vaibhavshirole/piano-reader/(commit log)

2025-01-19 Sketch to print mux map and notice signal leakage
    [drawmap.cpp]
2025-01-20 Discovery of which pull up resistor to use
2025-02-03 WebSocket server ESP32 firmware
