vaibhavshirole/piano-reader/images/IMG_0588.JPG

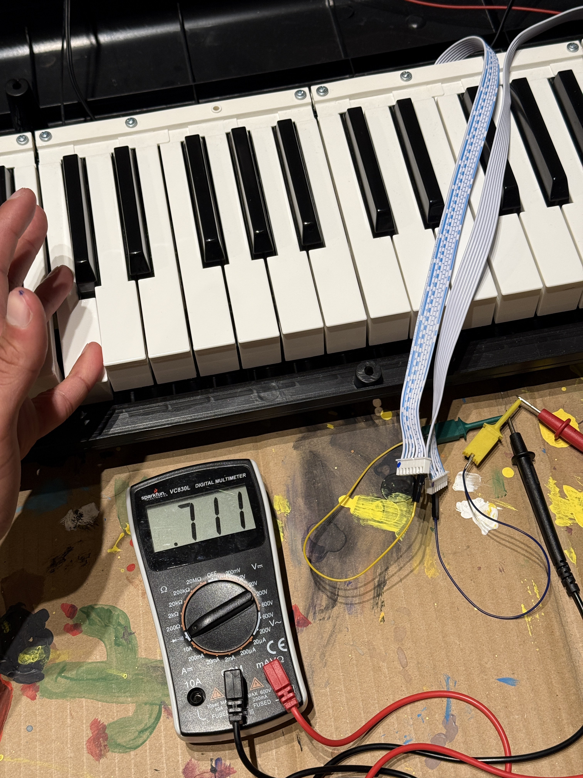
images/IMG_0588.JPG
