vaibhavshirole/piano-reader/images/IMG_0594.JPG

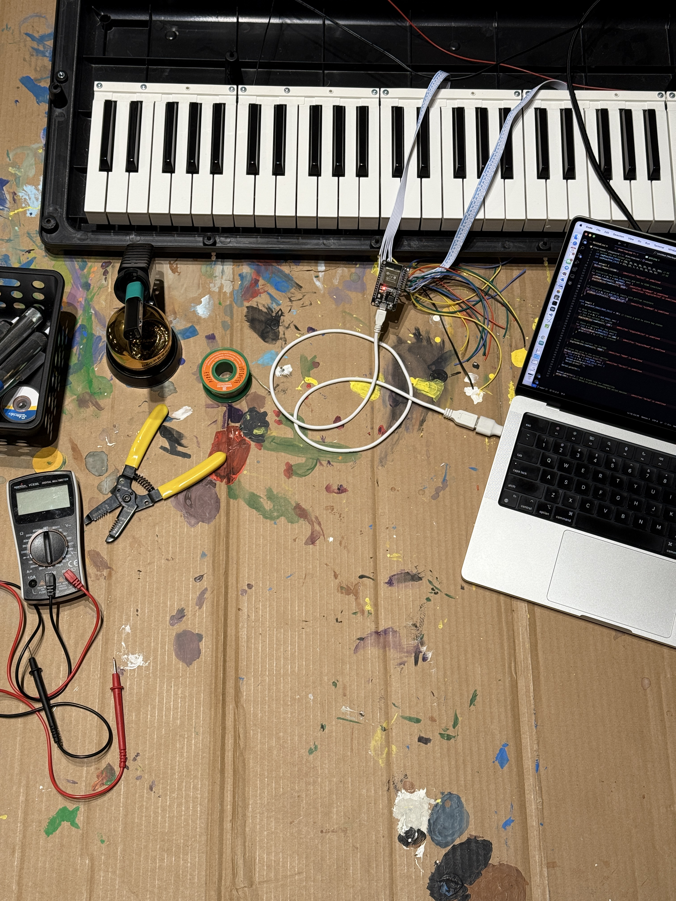
images/IMG_0594.JPG
