vaibhavshirole/piano-reader/images/IMG_0601.JPG

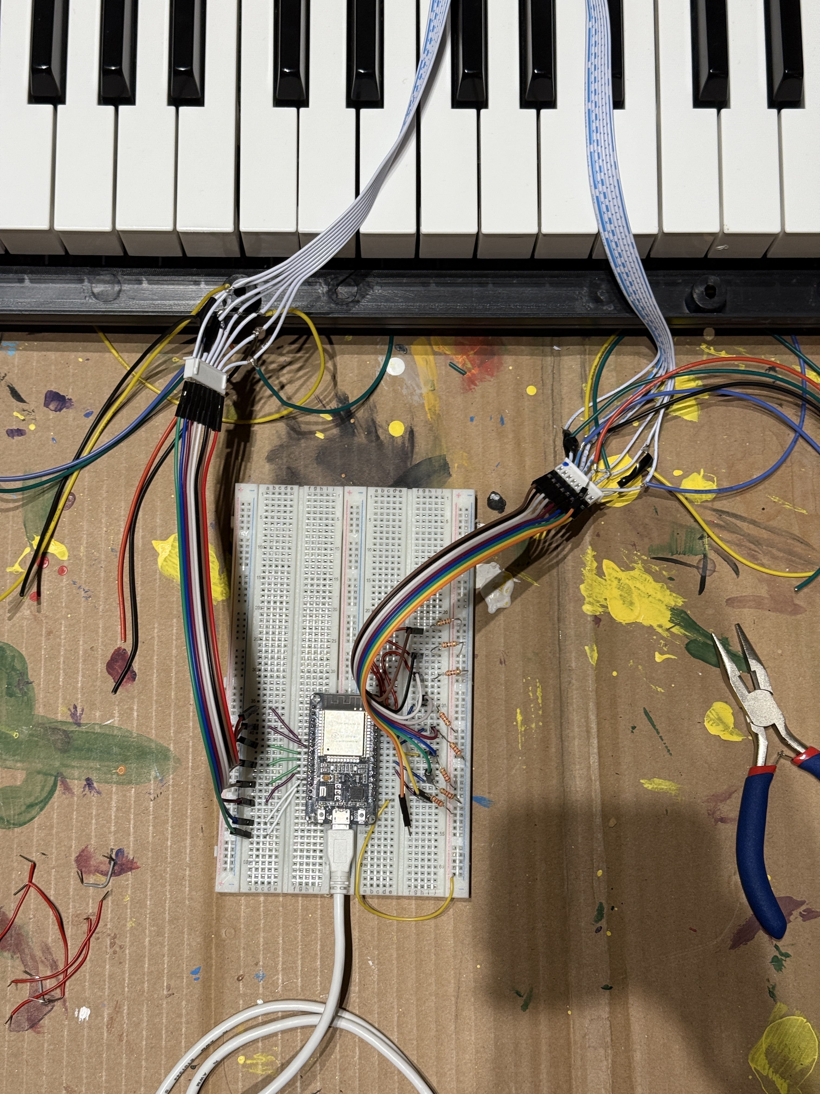
images/IMG_0601.JPG
